kemerelab/EweGo/Hardware/hub_cam/dimensions_stage5.png

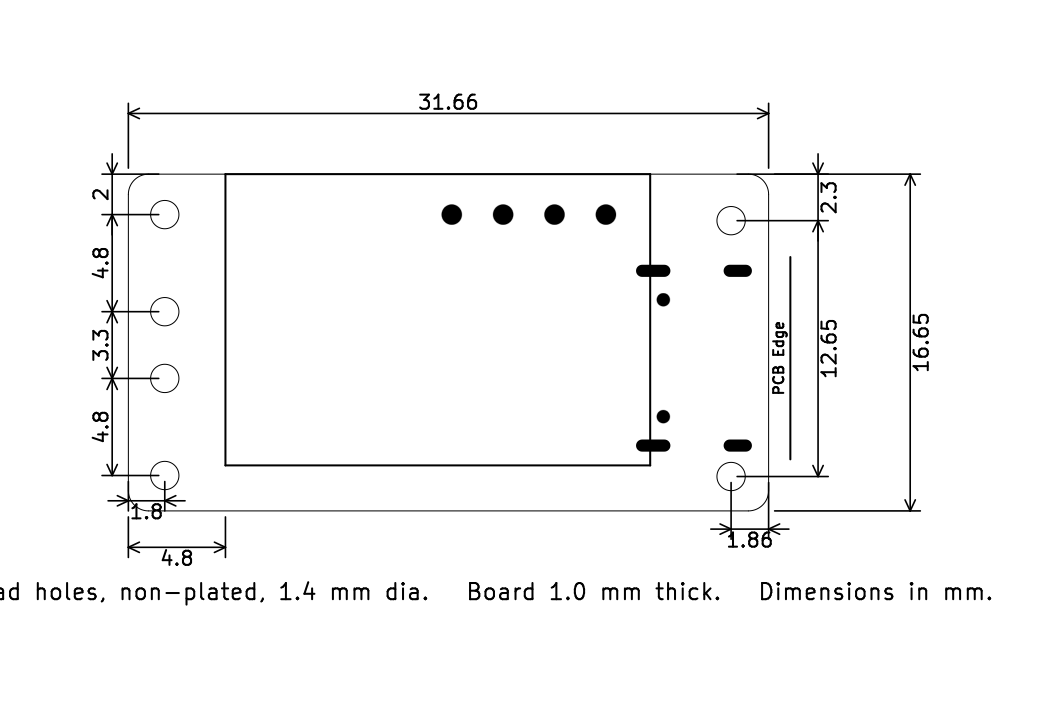
Hardware/hub_cam/dimensions_stage5.png
