kemerelab/EweGo/Hardware/hub_cam/render_stage6_iso.png

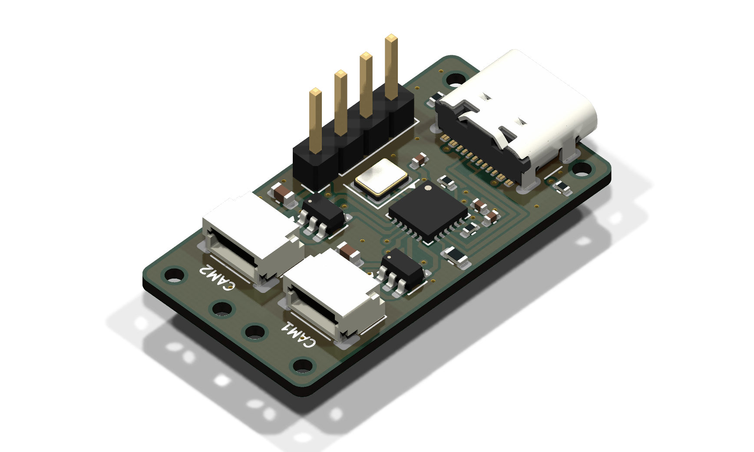
Hardware/hub_cam/render_stage6_iso.png
