kemerelab/EweGo/Hardware/hub_cam/schematic.png

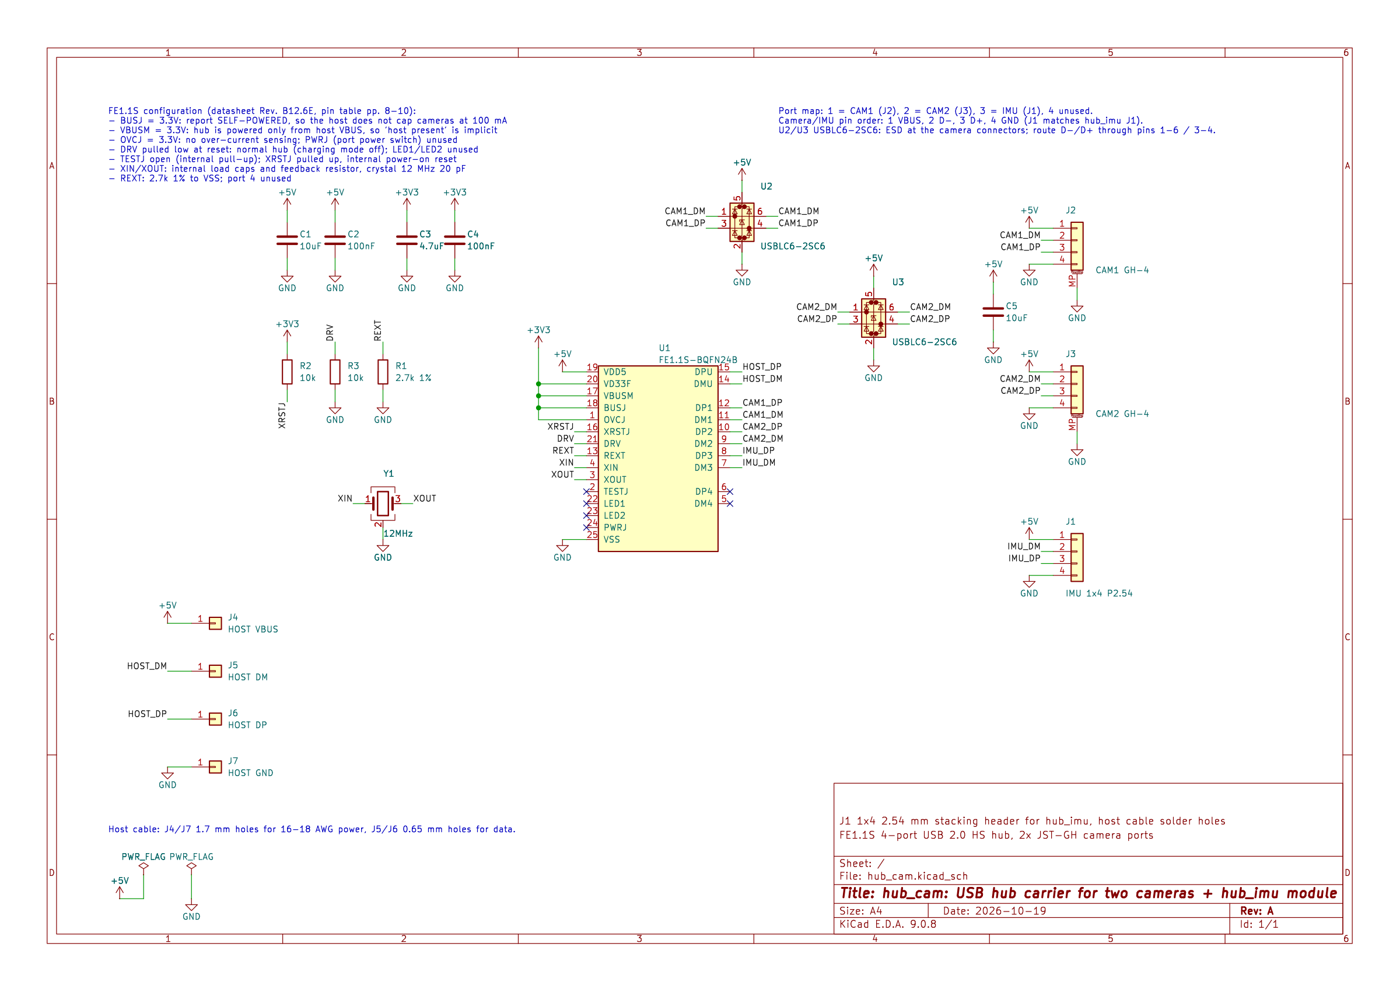
Hardware/hub_cam/schematic.png
