kemerelab/EweGo/Hardware/hub_cam/hub_cam.kicad_pcb

## KiCad design Hardware/hub_cam/hub_cam.kicad_pcb (2026-10-30)

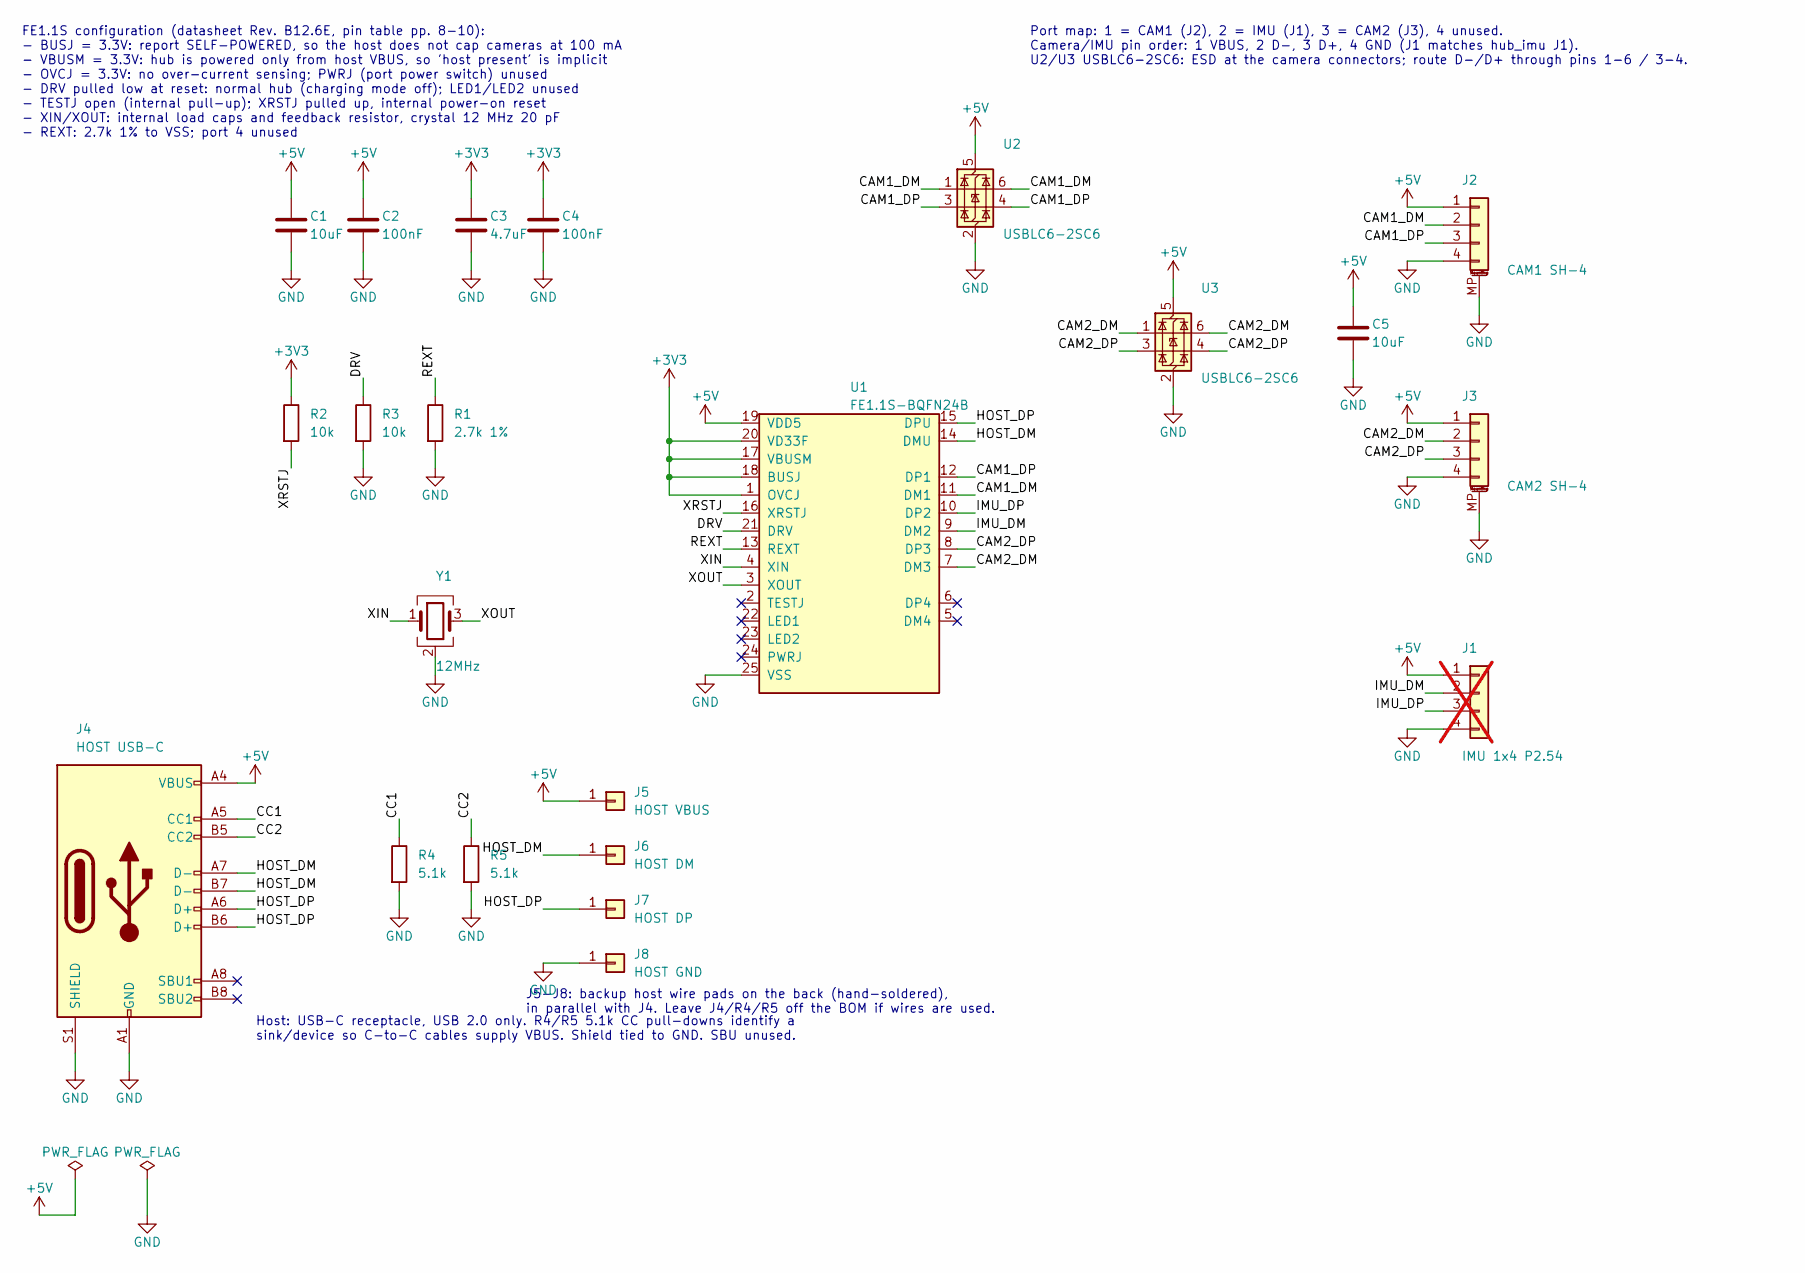
[picture p11: schematic hub_cam.kicad_sch, hub_cam: USB hub carrier for two cameras + hub_imu module]

Parts:
C1, C5: 10uF; C_0603_1608Metric; JLCPCB Part # C96446
C2, C4: 100nF; C_0402_1005Metric; JLCPCB Part # C1525
C3: 4.7uF; C_0402_1005Metric; JLCPCB Part # C23733
J1: IMU 1x4 P2.54; PinHeader_1x04_P2.54mm_Vertical; not fitted
J2: CAM1 SH-4; JST_SH_SM04B-SRSS-TB_1x04-1MP_P1.00mm_Horizontal; JLCPCB Part # C160404
J3: CAM2 SH-4; JST_SH_SM04B-SRSS-TB_1x04-1MP_P1.00mm_Horizontal; JLCPCB Part # C160404
J4: HOST USB-C; USB_C_Receptacle_GCT_USB4105-xx-A_16P_TopMnt_Horizontal; JLCPCB Part # C2765186
J5: HOST VBUS; SolderWirePad_1x01_SMD_1.5x3mm
J6: HOST DM; SolderWirePad_1x01_SMD_1.5x3mm
J7: HOST DP; SolderWirePad_1x01_SMD_1.5x3mm
J8: HOST GND; SolderWirePad_1x01_SMD_1.5x3mm
R1: 2.7k 1%; R_0603_1608Metric; JLCPCB Part # C13167
R2, R3: 10k; R_0402_1005Metric; JLCPCB Part # C25744
R4, R5: 5.1k; R_0402_1005Metric; JLCPCB Part # C25905
U1: FE1.1S-BQFN24B; QFN-24-1EP_4x4mm_P0.5mm_EP2.6x2.6mm; JLCPCB Part # C6776948
U2, U3: USBLC6-2SC6; SOT-23-6; JLCPCB Part # C7519
Y1: 12MHz; Crystal_SMD_3225-4Pin_3.2x2.5mm; JLCPCB Part # C9002

Connections:
+3V3: C3.1, C4.1, R2.1, U1.1 (OVCJ), U1.17 (VBUSM), U1.18 (BUSJ), U1.20 (VD33F)
+5V: C1.1, C2.1, C5.1, J1.1, J2.1, J3.1, J4.A4 (VBUS), J4.A9 (VBUS), J4.B4 (VBUS), J4.B9 (VBUS), J5.1, U1.19 (VDD5), U2.5 (VBUS), U3.5 (VBUS)
/CAM1_DM: J2.2, U1.11 (DM1), U2.1 (I/O1), U2.6 (I/O1)
/CAM1_DP: J2.3, U1.12 (DP1), U2.3 (I/O2), U2.4 (I/O2)
/CAM2_DM: J3.2, U1.7 (DM3), U3.1 (I/O1), U3.6 (I/O1)
/CAM2_DP: J3.3, U1.8 (DP3), U3.3 (I/O2), U3.4 (I/O2)
/CC1: J4.A5 (CC1), R4.1
/CC2: J4.B5 (CC2), R5.1
/DRV: R3.1, U1.21 (DRV)
/HOST_DM: J4.A7 (D-), J4.B7 (D-), J6.1, U1.14 (DMU)
/HOST_DP: J4.A6 (D+), J4.B6 (D+), J7.1, U1.15 (DPU)
/IMU_DM: J1.2, U1.9 (DM2)
/IMU_DP: J1.3, U1.10 (DP2)
/REXT: R1.1, U1.13 (REXT)
/XIN: U1.4 (XIN), Y1.1
/XOUT: U1.3 (XOUT), Y1.3
/XRSTJ: R2.2, U1.16 (XRSTJ)
GND: C1.2, C2.2, C3.2, C4.2, C5.2, J1.4, J2.4, J2.MP (MountPin), J3.4, J3.MP (MountPin), J4.A1 (GND), J4.A12 (GND), J4.B1 (GND), J4.B12 (GND), J4.S1 (SHIELD), J8.1, R1.2, R3.2, R4.2, R5.2, U1.25 (VSS), U2.2 (GND), U3.2 (GND), Y1.2 (G), Y1.4 (G)

Notes on the sheet:
FE1.1S configuration (datasheet Rev. B12.6E, pin table pp. 8-10): - BUSJ = 3.3V: report SELF-POWERED, so the host does not cap cameras at 100 mA - VBUSM = 3.3V: hub is powered only from host VBUS, so 'host present' is implicit - OVCJ = 3.3V: no over-current sensing; PWRJ (port power switch) unused 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
Port map: 1 = CAM1 (J2), 2 = IMU (J1), 3 = CAM2 (J3), 4 unused. Camera/IMU pin order: 1 VBUS, 2 D-, 3 D+, 4 GND (J1 matches hub_imu J1). U2/U3 USBLC6-2SC6: ESD at the camera connectors; route D-/D+ through pins 1-6 / 3-4.
J5-J8: backup host wire pads on the back (hand-soldered), in parallel with J4. Leave J4/R4/R5 off the BOM if wires are used.
Host: USB-C receptacle, USB 2.0 only. R4/R5 5.1k CC pull-downs identify a sink/device so C-to-C cables supply VBUS. Shield tied to GND. SBU unused.

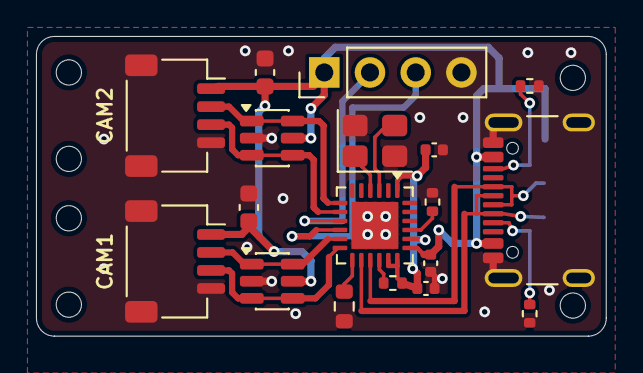
[picture p12: board hub_cam.kicad_pcb from above]

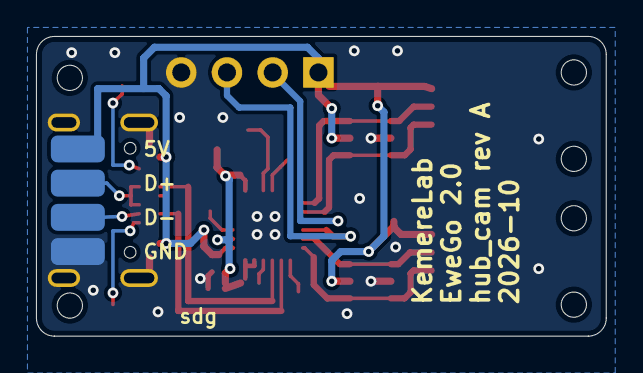
[picture p13: board hub_cam.kicad_pcb from below]

Board: 2 copper layers, 31.7 x 16.7 mm, 22 parts (4 on the bottom side), 18 nets.
