kemerelab/EweGo/Hardware/hub_imu/hub_imu.kicad_pcb

## KiCad design Hardware/hub_imu/hub_imu.kicad_pcb (2026-10-30)

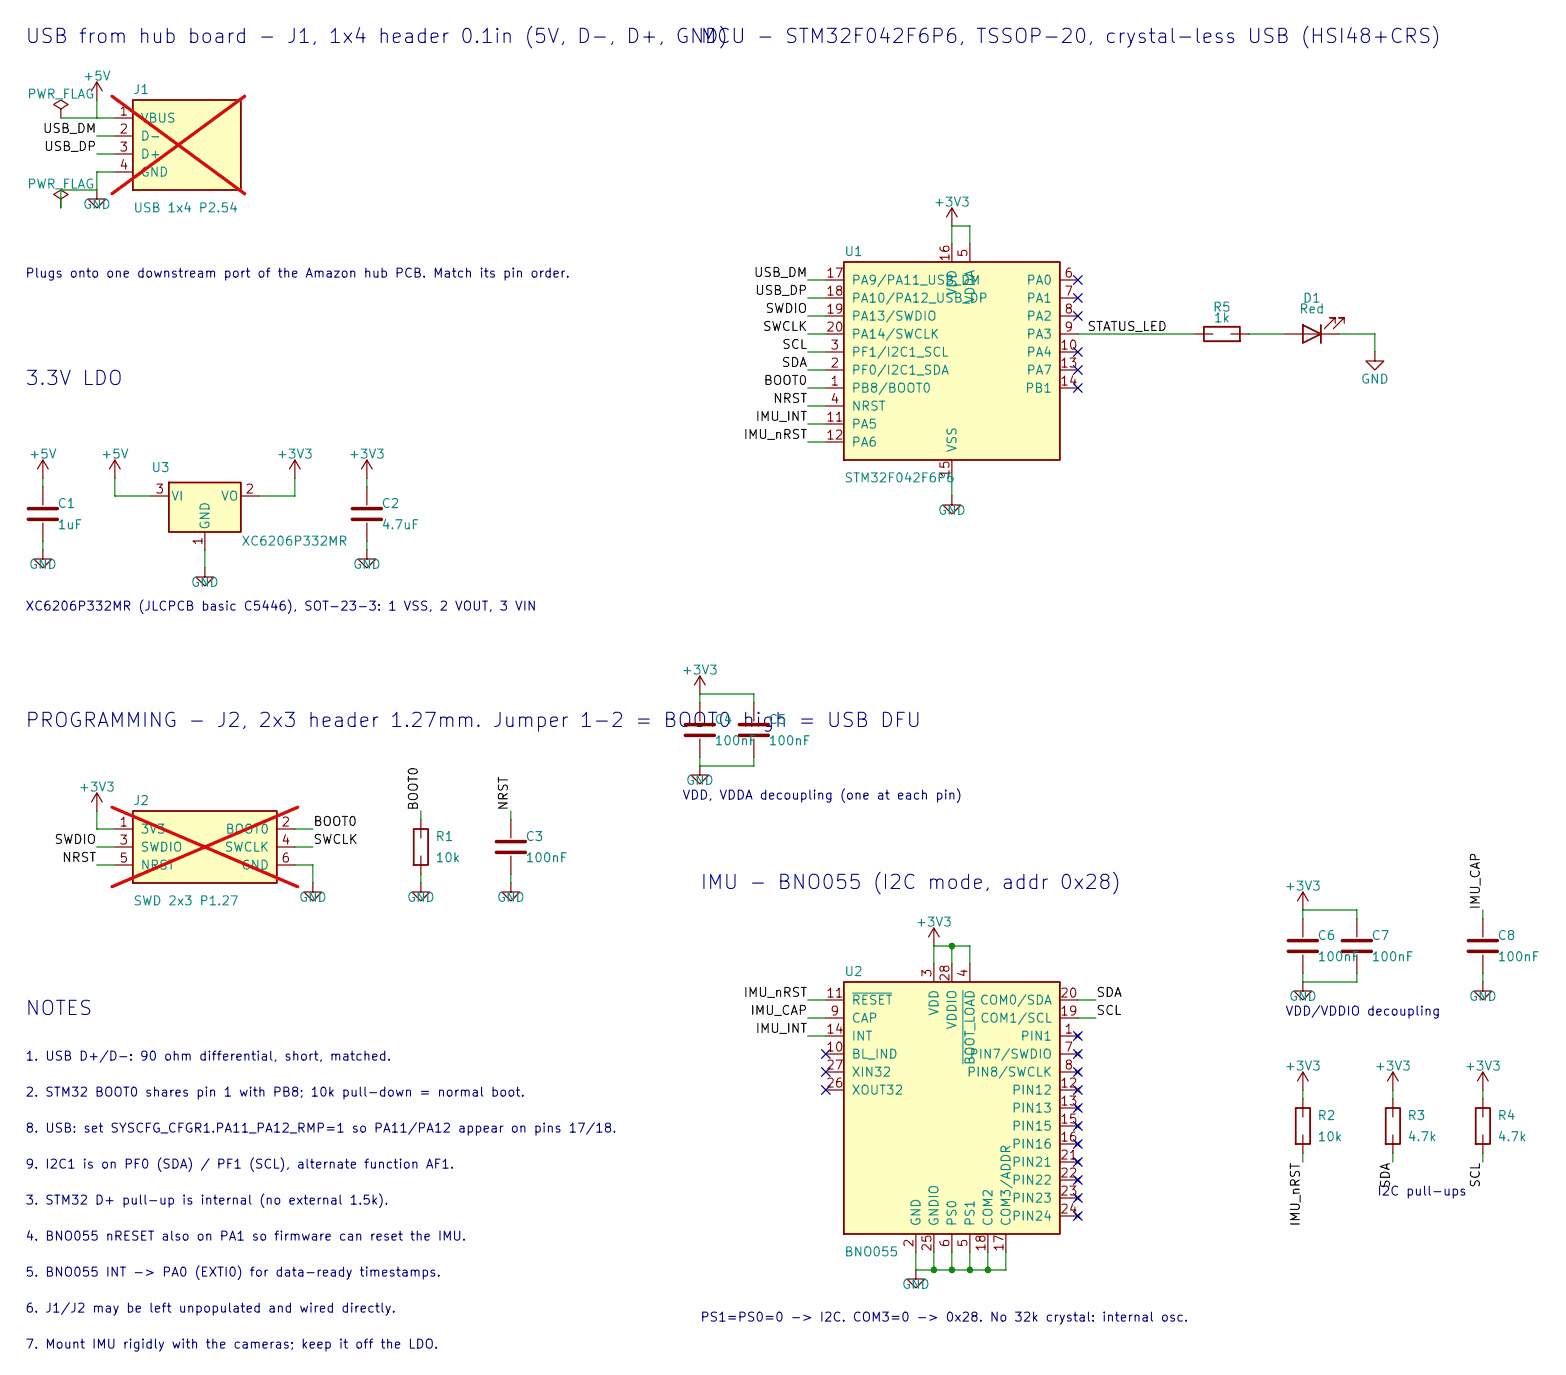
[picture p14: schematic hub_imu.kicad_sch, IMU USB bridge - stacks on hub PCB]

Parts:
C1: 1uF; C_0402_1005Metric; JLCPCB Part # C52923
C2: 4.7uF; C_0402_1005Metric; JLCPCB Part # C23733
C3, C4, C5, C6, C7, C8: 100nF; C_0402_1005Metric; JLCPCB Part # C1525
D1: Red; LED_0603_1608Metric; JLCPCB Part # C2286
J1: USB 1x4 P2.54; PinHeader_1x04_P2.54mm_Vertical; not fitted
J2: SWD 2x3 P1.27; PinHeader_2x03_P1.27mm_Vertical; not fitted
R1, R2: 10k; R_0402_1005Metric; JLCPCB Part # C25744
R3, R4: 4.7k; R_0402_1005Metric; JLCPCB Part # C25900
R5: 1k; R_0402_1005Metric; JLCPCB Part # C11702
U1: STM32F042F6P6; TSSOP-20_4.4x6.5mm_P0.65mm
U2: BNO055; LGA-28_5.2x3.8mm_P0.5mm
U3: XC6206P332MR; SOT-23-3; JLCPCB Part # C5446

Connections:
+3V3: C2.1, C4.1, C5.1, C6.1, C7.1, J2.1 (3V3), R2.1, R3.1, R4.1, U1.5 (VDDA), U1.16 (VDD), U2.3 (VDD), U2.4 (~BOOT_LOAD), U2.28 (VDDIO), U3.2 (VO)
+5V: C1.1, J1.1 (VBUS), U3.3 (VI)
/BOOT0: J2.2 (BOOT0), R1.1, U1.1 (PB8/BOOT0)
/IMU_CAP: C8.1, U2.9 (CAP)
/IMU_INT: U1.11 (PA5), U2.14 (INT)
/IMU_nRST: R2.2, U1.12 (PA6), U2.11 (~RESET)
/NRST: C3.1, J2.5 (NRST), U1.4 (NRST)
/SCL: R4.2, U1.3 (PF1/I2C1_SCL), U2.19 (COM1/SCL)
/SDA: R3.2, U1.2 (PF0/I2C1_SDA), U2.20 (COM0/SDA)
/STATUS_LED: R5.1, U1.9 (PA3)
/SWCLK: J2.4 (SWCLK), U1.20 (PA14/SWCLK)
/SWDIO: J2.3 (SWDIO), U1.19 (PA13/SWDIO)
/USB_DM: J1.2 (D-), U1.17 (PA9/PA11_USB_DM)
/USB_DP: J1.3 (D+), U1.18 (PA10/PA12_USB_DP)
GND: C1.2, C2.2, C3.2, C4.2, C5.2, C6.2, C7.2, C8.2, D1.1 (K), J1.4 (GND), J2.6 (GND), R1.2, U1.15 (VSS), U2.2 (GND), U2.5 (PS1), U2.6 (PS0), U2.17 (COM3/ADDR), U2.18 (COM2), U2.25 (GNDIO), U3.1 (GND)
unnamed: D1.2 (A), R5.2

Notes on the sheet:
3. STM32 D+ pull-up is internal (no external 1.5k).
Plugs onto one downstream port of the Amazon hub PCB. Match its pin order.
IMU - BNO055 (I2C mode, addr 0x28)
8. USB: set SYSCFG_CFGR1.PA11_PA12_RMP=1 so PA11/PA12 appear on pins 17/18.
PROGRAMMING - J2, 2x3 header 1.27mm. Jumper 1-2 = BOOT0 high = USB DFU
7. Mount IMU rigidly with the cameras; keep it off the LDO.
9. I2C1 is on PF0 (SDA) / PF1 (SCL), alternate function AF1.
I2C pull-ups
USB from hub board - J1, 1x4 header 0.1in (5V, D-, D+, GND)
VDD, VDDA decoupling (one at each pin)
PS1=PS0=0 -> I2C. COM3=0 -> 0x28. No 32k crystal: internal osc.
5. BNO055 INT -> PA0 (EXTI0) for data-ready timestamps.
1. USB D+/D-: 90 ohm differential, short, matched.
6. J1/J2 may be left unpopulated and wired directly.
NOTES
VDD/VDDIO decoupling
MCU - STM32F042F6P6, TSSOP-20, crystal-less USB (HSI48+CRS)
3.3V LDO
XC6206P332MR (JLCPCB basic C5446), SOT-23-3: 1 VSS, 2 VOUT, 3 VIN
4. BNO055 nRESET also on PA1 so firmware can reset the IMU.
2. STM32 BOOT0 shares pin 1 with PB8; 10k pull-down = normal boot.

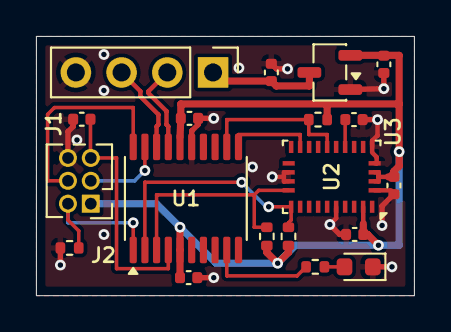
[picture p15: board hub_imu.kicad_pcb from above]

Board: 2 copper layers, 21.0 x 14.4 mm, 19 parts (0 on the bottom side), 16 nets.
