kemerelab/EweGo/(commit log)

2026-01-03 Updated dual camera script with excess removed
2026-07-15 record_sensors: replace sensor_test.py with expanded orchestrator
    The unified sensor orchestrator moves from Firmware/sensor_test.py to
    Firmware/record_sensors.py (new file, ~780 lines vs. 460). Docs and
    downstream references updated to match the new path.
    [record_sensors.py]
2026-07-15 setup: RTC substitute, boot pre-sync, persistent journal, sensor service
    pi_setup.sh gains four sections that harden unattended operation:
    §7.5 Wall-clock save/restore. CM4 has no battery RTC; a minute-cadence
    touch on /var/lib/ewego/clock plus a boot-time forward-only step
    bounds post-reboot staleness to ~60 s. Prevents the 2026-07-08
    time-island split where a stale-anchor ewe1 was outvoted by the
    rest of the flock as a falseticker.
    §7.6 Boot pre-sync via `chronyd -q` against any live mesh peer before
    chronyd starts. If a peer answers within 25 s the node rejoins
    at ~0 offset; on cold-boot with no peers it falls back to the
    r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
2026-07-15 mesh: ops tooling (list/record/monitor) + BSSID and OGM tuning
    New helpers for the mesh once it's up:
    mesh_list.sh - ping-sweep bat0, print IP/MAC/hostname table,
    cross-checked against batman-adv originator count.
    mesh_record.sh - start/stop/status for record_sensors.py --no-gps on
    every peer over SSH. Standalone fallback for when
    mesh_monitor is unavailable.
    mesh_monitor.py - TUI on the laptop showing per-peer chrony tracking,
    pairwise offset spread, fuel gauge, storage, recording
    status, and the batman-adv TQ matrix. [r]/[s] drive
    the sensor service; [b] bursts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
2026-07-15 chrony/GPS: SHM refclock + xleave polling + trusted laptop source
    New gps-test/chrony_shm.py wraps SysV IPC segment 'NTP0'+N so chrony's
    `refclock SHM N` picks up GPS time samples. Segment layout matches
    gpsd/ntpsec conventions; unit 0 by default. Silent no-op on OSError.
    gps_logger.py feeds each valid NAV-PVT fix into segment 0 (paired with
    `refclock PPS ... lock GPS` in chrony.conf for sub-µs alignment). Falls
    back to mesh peers if SHM setup fails.
    chrony.conf tuning:
    - Mesh peers now `minpoll 0 maxpoll 2 xleave polltarget 30 maxdelay 0.1`.
    xleave gives ~100µs better than software RX timestamping. polltarget
    30 (vs default 8) keeps chrony actually polling at 1-4 s. maxdelay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
    [chrony_shm.py, gps_logger.py]
2026-07-15 sync_validation: multi-pair summary + NaN-safe drift fit
    analyze_sync.py:
    - New summary_plot() combining residual lag(t) for all pairs plus
    ppm/scatter bar charts, giving a single overview figure for a
    ref-vs-N validation run.
    - Guard the audio-drift np.polyfit against <2 in-band samples. A pair
    with lag spread across many ms yields keep.sum()<2 after the ±0.5 ms
    median filter; return NaN ppm/scatter and log a warning instead of
    crashing.
    - Return the raw ats/alag arrays from overview_figure so summary_plot
    can re-plot them without recomputing GCC-PHAT.
    - Doc: recorder name updated to record_sensors.py.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
2026-07-15 dualcam: rebase-safe timestamps, aligned export, UDP mesh preview
    bugs/002 documents picamera2's per-encoder timestamp rebase to zero
    (Michigan Apr 2026 captures show first frame = 0, µs-since-first-frame
    after — not directly cross-alignable).
    dual_cam_jp2.py fix:
    - New on-disk format tagged with "EWEGOTS2" magic, storing (pi_us,
    rebased_us) pairs. pi_us is time.monotonic_ns()//1000 at outputframe
    time; rebased_us is picamera2's SoF-accurate delta. Reconstruct
    absolute monotonic timestamps as pi_us[0] + rebased_us[i].
    - Per-camera stall watchdog: last_frame_pi_us tracked so a silent
    single-camera death (ewe5 2026-07-09: cam2 stopped ~25 s in) can
    trip a monitor ra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
    [align_streams.py, dual_cam_jp2.py, play_with_timestamps.py]
2026-07-15 sensors: cadence-batched fsync on companion CSVs
    Michigan 2026-04-13: a hardware watchdog reset produced kilobytes of
    trailing NUL bytes on IMU/audio/fuel-gauge companion CSVs. Filehandle
    flush() only pushes to the kernel — the SD card firmware buffered the
    writes and lost them on reset.
    - IMU: fsync every ~1 s (batched with the existing 10-sample flush).
    - Audio: fsync the timestamps CSV every ~1 s from the main thread
    (never inside the sounddevice RT callback). The WAV survives via
    RIFF finalize on context-manager exit.
    - Fuel gauge: per-row fsync — writer runs at 0.5 Hz so 2 syncs/min is
    negligible SD wear and caps loss at one sample.
    Caps data loss at <1 s across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
    [log_imu_data.py, max17048_test.py]
2026-07-15 setup: tty_probe.py — diagnose cbreak single-key input
    Small standalone diagnostic for when mesh_monitor's [r]/[s]/[b] keys
    don't register — reports isatty state, TERM, foreground pgid, and
    echoes raw bytes on each keypress. Helps distinguish line-buffering,
    multiplexer interception, and non-TTY stdin.
2026-07-15 dualcam/README: document align_streams.py multi-device export
    Adds a section covering align_streams.py: what it composites, how
    clock-sync rectification and wall-clock alignment work, an annotated
    five-device example command (fiveway_0459_final_1620p30.mp4), the
    common CLI flags including --wall-offset, and the multi-device row
    layout.
2026-09-04 Add CI-built collar image (Phase A)
    Builds a ready-to-flash Raspberry Pi OS Lite arm64 image with the current
    Python firmware installed but not enabled, apt packages (picamera2, smbus2,
    pyserial, i2c-tools) installed inside the image at build time via an
    emulated chroot, pyubx2 vendored as pure wheels, USB host mode verified,
    UART0 console kept, and the pi_setup.sh hardware block in config.txt.
    Wi-Fi/hostname/user come from Raspberry Pi Imager; no first-boot steps.
2026-09-04 Add ffmpeg to the collar image
    For ad-hoc USB camera streaming and transcoding tests; not used by the
    recording scripts.
2026-09-05 Add browser test console (ewego-webtest) to the collar image
    Single-file, stdlib-only HTTP server on port 8080: status strip (image
    version, clock sync, battery, disk, devices, unit states), one test per
    sensor with streamed output, live MJPEG camera view via v4l2-ctl, unit
    start/stop and journal tails, session listing. Enabled by default on the
    image; no authentication, bench/lab networks only.
2026-09-09 GPS: 5 Hz navigation rate, PPS on GPIO 6, documented module configuration
    - SheepRTK.ucf: CFG-RATE-MEAS 100 -> 200 ms so RXM-RAWX on all bands
    stays well inside 460800 baud
    - validate_ubx.py and the GPS docs now expect ~5 Hz
    - CONFIGURING_HW.md decodes every key the .ucf files set, records the
    UART/timepulse pin mapping from the eweSAW schematic (data on UART4,
    TP1 on GPIO 6), and describes software and PPS timing
    - image: dtoverlay=pps-gpio,gpiopin=6 so /dev/pps0 exists
2026-09-09 image: leave GPIO 4/5 (unused UART3 to the GNSS header) as unpulled inputs
    The module's second UART is not used; with the uart3 overlay loaded GPIO 4
    was an actively driven TX output on the header, and even without it the
    default pull-up shows 3.3 V there. gpio=4,5=ip,pn makes both pins plain
    floating inputs from firmware onward.
2026-09-09 webtest: PPS feedback
    Status strip shows /dev/pps0 presence, live/stale, sequence, measured
    rate, and the system clock's offset from the GPS second at the last edge.
    GPS card gains a 'PPS watch' that prints every edge for N seconds with
    inter-edge interval and offset, and flags missed edges.
    [ewego_webtest.py]
2026-09-09 webtest: simultaneous multi-camera drop test
    Runs v4l2-ctl --verbose on every camera at once to /dev/null and accounts
    for lost frames from the kernel per-buffer sequence numbers: per camera
    frames received, gaps and where, error-flagged frames, effective fps,
    interval min/max, data rate; PASS/FAIL plus recent UVC/USB dmesg lines.
    [ewego_webtest.py]
2026-09-09 webtest: make the multi-camera drop test explain a silent camera
    - v4l2-ctl --stream-poll so a camera that starts but never delivers a
    frame reports 'select timeout' instead of blocking until killed
    - staggered starts (default 1 s) to avoid simultaneous alt-setting
    negotiation on the shared USB 2.0 root
    - progress marks cameras streaming with no frames; result block says
    whether v4l2-ctl exited or was killed, quotes its output, and gives the
    usual causes; kernel messages during the test and lsusb -t appended
    - buttons to reload uvcvideo with/without quirks=128 (bandwidth fix)
    [ewego_webtest.py]
2026-09-09 webtest: list only USB cameras, selectable for the drop test
    Enumerate cameras from /dev/v4l/by-path/*usb*-video-index0 (one capture
    node per UVC camera, labelled by physical hub port) instead of every
    V4L2 node, which on a Pi includes the codec, ISP and HEVC devices. The
    drop test gets a checkbox per camera.
2026-09-09 webtest: UVC bandwidth probe and live alt-setting in the drop test
    Shows what each camera asks the bus for (alternate setting and bytes per
    microframe) via uvcvideo tracing, and the drop test reports the live alt
    setting per camera. On the Pi 6.12 kernel quirks=128 only affects
    uncompressed formats, so an MJPEG camera's own request is what counts.
2026-09-09 Patched uvcvideo with a max_payload cap, built into the image
    Two of the collar's MJPEG cameras cannot share the CM4's single USB 2.0
    bus: the camera requests 3060 B/microframe at every format and the bus
    budget is ~6000. quirks=128 only rewrites uncompressed requests on the
    6.12 kernel. This adds a 'max_payload' module parameter (patch anchored on
    exact source lines, verified in CI against rpi-6.12.y), builds the module
    in the image chroot against the exact kernel headers, installs it under
    /lib/modules/<ver>/updates/, and sets max_payload=2048 via modprobe.d.
    Also: CLAUDE.md handoff notes for cloud sessions; web console shows the
    module path and max_payload in the bandwidth probe.
    Co-Aut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
2026-09-09 Add ewego-cam: static C UVC recorder with kernel timestamps and drop accounting
    Single-file V4L2 recorder (no libuvc): writes concatenated MJPEG frames,
    int64 us CLOCK_MONOTONIC timestamps (same format as the CSI recorder),
    a 32-byte index record per frame (offset, timestamp, driver sequence,
    bytes, flags) and a JSON summary with lost/gap/error counts, interval
    statistics and the realtime-minus-monotonic offset. Exit 2 on any lost or
    error-flagged frame, 3 on stall. Device selection by USB hub port
    (port:1.3) via /dev/v4l/by-path. sd_notify status line without libsystemd.
    CI compiles it natively with -Werror and cross-compiles a static arm64
    binary that the image injector installs to /usr/l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
    [ewego_webtest.py]
2026-09-09 Zero free space before compressing the image; strip ewego-cam; recorder test in the console
    The purged build tools left dirty free blocks that xz could not compress
    (~130 MB of extra download). zerofree on the unmounted rootfs before
    hashing brings the image back to size. ewego-cam is linked with -s.
    The web console gains 'Record test with ewego-cam' for the selected
    cameras, showing each recorder's live stats and summary.json.
2026-09-09 uvcvideo: hold kernel packages; console probe shows kernel/module inventory
    A collar running a different kernel than the image was built with loads
    the stock uvcvideo (no max_payload). The probe now prints uname -r, the
    module path in use, each /lib/modules/* with its updates/ contents, the
    modprobe setting and the image version, and the image holds the kernel
    packages so apt upgrade cannot cause the mismatch.
2026-09-09 image: no apt at first boot (cloud-init package module removed), avahi-daemon baked in
    Raspberry Pi Imager's cloud-init user-data installs avahi-daemon and can
    run a full package upgrade on first boot. On the test collar that replaced
    the kernel (6.18.34 -> 6.18.39), so the patched uvcvideo built for the
    image's kernel was no longer the one loading. The injector now writes
    /etc/cloud/cloud.cfg.d/99-ewego-no-apt.cfg that drops the package module
    from cloud_config_modules (user-data cannot re-add a module), and
    avahi-daemon is installed at build time instead. Kernel packages are also
    held (previous commit). Console gets an 'apt / first-boot history' button.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
    [ewego_webtest.py]
2026-09-09 image: strip the cloud-init package module from whichever stage list holds it
2026-09-09 webtest: alternate-setting table, live max_payload setter, reserved bandwidth from the kernel trace
    The cap selects the smallest alternate setting at or above it; this camera
    has none between 2048 and 2880, so max_payload=2048 lands on 2880 and two
    cameras still exceed the bus budget. The probe now lists the camera's
    alternate settings (from lsusb, which shows the high-bandwidth multiplier
    sysfs hides), the console can set max_payload at runtime, and the drop
    test reports each camera's actual reservation and the total.
2026-09-09 uvcvideo: max_payload default 1900 (bench PASS: two cameras 1080p30, 0 lost)
    The collar camera's alternate settings are 800/944/1280/1600/1984/2880/
    3060 B/microframe and the driver rounds the capped request up, so 2048
    landed on 2880 and two cameras still exceeded the bus; 1900 lands on 1984,
    3968 total, zero frames lost on both cameras at 1920x1080 30 fps. Console
    alt-setting table now excludes the cameras' audio interfaces.
2026-09-10 ewego-cam 0.2: writer thread with steady writeback; uvcvideo keeps 32 URBs in flight
    Bench: two cameras recording 1080p30 to the SD card lost 5-9 frames each
    at every 5 s fdatasync (200-340 ms stalls) although v4l2-ctl to /dev/null
    at the same settings lost none. The capture thread now only dequeues,
    copies into a RAM queue (--ring, 64 MB) and requeues; a writer thread
    drains it, starting writeback every --wb MB (4) with sync_file_range and
    dropping written chunks from the page cache, so there is no periodic
    flush burst. Queue overruns, queue peak and the longest write are reported.
    The driver patch also raises UVC_URBS 5 -> 32 (~20 ms -> ~128 ms of
    USB-side buffering) since URB resubmission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
2026-09-10 notes: v0.4.5 built (writer thread, 32 URBs)
2026-09-10 gps_logger: NTRIP configurable and bounded, off by default
    The caster was hard-coded to the lab LAN and connect() had no timeout,
    so away from the lab the logger blocked for up to two minutes at start
    (and a systemctl stop during that window showed a KeyboardInterrupt
    traceback). Now: --ntrip HOST:PORT/MOUNTPOINT[,USER:PASS] or $EWEGO_NTRIP,
    --no-ntrip, 5 s connect timeout, 10 s recv timeout; the unit reads
    NTRIP_ARGS from /etc/ewego/gps.conf (empty = no corrections).
    [gps_logger.py]
2026-09-10 webtest: serial-over-TCP bridge for PyGPSClient
    Exposes the GNSS UART on a TCP port (default 5010), both directions, one
    client at a time, from the GPS card. Refuses while ewego-gps owns the
    port; shares the raw-read lock. Standard library only.
2026-10-03 image: add dfu-util for flashing the hub_imu USB IMU module through the hub
2026-10-04 hub_imu firmware step 1: USB enumeration, LED, console with dfu reboot
    Bare CMSIS + TinyUSB 0.21 for the STM32F042F6P6 on the hub_imu module
    (Firmware/hub_imu/). Composite CDC console + HID data interface (HID is
    present but idle until step 3). HSI48 + CRS, PA11/PA12 remap, SysTick
    LED blink, 'dfu' command reboots into the system bootloader via a
    .noinit magic word checked in Reset_Handler.
    Own workflow (hub-imu-firmware.yml): fetch pinned deps, build with
    gcc-arm-none-eabi, enforce flash/RAM budget, upload hub_imu.bin; release
    on hubimu-v* tags. The image workflow now ignores Firmware/hub_imu/.
    [main.c, startup.c, tusb_config.h]
2026-10-04 hub_imu firmware step 2: I2C and BNO055 bring-up on the console
    I2C1 master on PF0/PF1 (100 kHz from SYSCLK, timeouts, NACK handling);
    BNO055 reset via PA6, chip-ID poll, NDOF mode. Console gains id (chip,
    sensor and firmware IDs, sys_status/sys_err), cal, read (formatted
    46-byte burst with its I2C time), init. LED blinks 2 Hz if the sensor
    failed. USB is serviced during the sensor's boot delay. CI adds a DFU
    suffix (hub_imu.dfu) alongside the raw .bin.
    [bno055.c, bno055.h, i2c.c, i2c.h, main.c]
2026-10-05 hub_imu firmware step 3: 100 Hz HID sample stream
    One 64-byte HID report per sample (report.h): version, flags, 16-bit
    sequence, 32-bit device microsecond timestamp from a free-running TIM2,
    the 46-byte BNO055 burst, the I2C read time and the period. Sampling is
    paced by the device clock with resync if it falls behind; reports the
    host did not drain are counted and flagged. I2C moved to 400 kHz.
    Console: stats, stream (toggle).
2026-10-05 ewego-imu-usb host logger, unit, console card; CI builds it
    Static C logger for the hub_imu HID stream: finds the module by VID:PID,
    stamps each report with CLOCK_MONOTONIC/REALTIME, writes the UART-era IMU
    CSV columns plus host_mono_us/dev_ts_us/seq/i2c_us/flags, counts sequence
    gaps and flagged samples, reports device-vs-host drift; summary.json; exit
    2 on loss. Unit ewego-imu-usb reads /etc/ewego/imu-usb.conf. Console gets
    a USB IMU card (read stream, start/stop/journal). Firmware stats buffer
    widened.
    [ewego-imu-usb.c, ewego_webtest.py, main.c]
2026-10-05 bus-test.py: IMU + camera bus test for macOS (IOKit via ctypes, ffmpeg) and Linux (hidraw, v4l2-ctl)
    Verified on the Mac: hub_imu at 100.0 Hz, 0 lost, device-clock intervals
    9992-10008 us, while one or two cameras stream. On macOS ffmpeg's
    avfoundation only reaches the cameras' raw 5 fps mode, so cameras there
    are a bus load, not a frame-rate test; the collar does the counting.
2026-10-06 Camera listing: one entry per device node (udev makes -usb- and -usbv2- by-path links)
2026-10-06 notes: collar bus test passed (two cameras 1080p30 + IMU 100 Hz, 0 lost)
2026-10-07 units: word-split EXTRA_ARGS/DEVICE_ARG ($VAR, not ${VAR}) so ewego-cam and ewego-imu-usb get separate arguments
    With braces systemd passes the whole value as one argument, so
    ewego-cam received an option literally named '--stats 5' and exited 1.
2026-10-07 ewego-cam 0.3: hold the frame rate (clear UVC exposure-auto-priority) unless --auto-fps
    Both cameras delivered 24.4 fps in a dim room with contiguous sequence
    numbers: auto-exposure was lengthening the exposure past the frame
    period. Logging wants a constant rate and darker frames.
2026-10-07 recorders wait for their device after a hub reset instead of failing
    A hub reset re-enumerates the cameras and the IMU module a few seconds
    later than systemd's restart; ewego-cam (--wait, 30 s) and ewego-imu-usb
    now poll for the device before giving up.
    [ewego-imu-usb.c]
2026-10-30 Move hub_imu and hub_cam boards into Hardware/, firmware with its board
    - Hardware/hub_imu (EweFeel USB IMU) and Hardware/hub_cam (camera hub)
    copied from github.com/ckemere/usb-imu at 4be5fb1, without history;
    that repo keeps it. Each board gets a NOTES.md (history, status,
    gotchas) next to its README; Hardware/README.md indexes the folder.
    - Firmware/hub_imu -> Hardware/hub_imu/firmware; hub-imu-firmware.yml
    follows, and the image build now ignores Hardware/**.
    - README: project name expansion (Extensible Wearable for Egocentric and
    Group Observation) and a shorter overview.
    - .gitignore: firmware build dirs at the new path, KiCad transient files,
    .DS_Store.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
2026-10-30 docs: call the device a wearable (collar and head-halter variants)
    "Collar" stays where it means the collar variant or the test unit.
2026-11-13 Make the USB recorders the default: ewego-record.target, no Picamera2
    ewego-sensors launched the Picamera2 dual-camera script; with no CSI
    cameras libcamera hands it the USB webcams through its UVC pipeline and
    configure() fails ("Control FrameDurationLimits is not advertised").
    - image/units/ewego-record.target wants ewego-cam@camera1/2, ewego-imu-usb,
    ewego-gps and the new ewego-audio (record_audio.py / arecord) and
    ewego-fuel (Firmware/fuel_gauge/log_fuel_gauge.py, same CSV columns as
    sensor_test.py wrote); members are PartOf= the target so stop/restart
    propagate. /etc/ewego/audio.conf and fuel.conf added.
    - ewego-sensors and ewego-dualcam units removed; python3-picamera2, the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
2026-11-13 CI: pin runners to ubuntu-24.04
    ubuntu-latest moved to Ubuntu 26.04 on 2026-11; the image job failed at
    'Install build tools' with "Package 'qemu-user-static' has no installation
    candidate". Pin all jobs to 24.04, where every previous image built.
2026-11-13 Camera confs default to hub_cam ports 1.1 / 1.3
    On the collar ewego-cam --list showed the cameras on port:1.1 and port:1.3
    (the hub_cam layout); v0.6.0 shipped 1.3 / 1.4 from the hand-wired hub, so
    camera2 waited for an empty port and only one camera recorded.
2026-11-13 ewego-cam 0.4: --device auto:N[/M] picks cameras by hub-port order
    The camera confs no longer name a hub port. auto:N/M enumerates the USB
    cameras from /dev/v4l/by-path, orders them by hub port (strverscmp, so
    1.1 < 1.3 < 1.10) and takes the Nth, expecting M in all. camera1 is thus
    the camera on the lower port on any hub, independent of /dev/videoN
    numbering. The set must be unchanged for three 500 ms polls before the
    choice is made (after a hub reset the cameras come back one at a time);
    if fewer than M appear within --wait the recorder uses what is there and
    says so, rather than record nothing. --list prints both auto: and port:
    forms. Confs default to auto:1/2 and auto:2/2; port: still pi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
2026-11-13 v0.6.3: threaded IMU logger, live field dashboard, run check, console shutdown
    ewego-imu-usb 0.3: reader thread (hidraw poll + timestamps only, --rt for
    SCHED_FIFO) and writer thread behind a RAM ring of 8192 samples, after 0.2
    lost 480 samples in 9 gaps when its CSV write blocked on the SD card under
    camera load (the kernel keeps 64 reports per hidraw reader). Ring overruns
    are counted in the summary and fail the exit code.
    Both C recorders take --live DIR (newest JPEG and counters for the cameras,
    counters plus the last 64 samples for the IMU, on tmpfs) and --preview
    (live files only, nothing recorded). The confs enable --live /run/ewego
    and --rt for the IMU.
    Console: /live dashboard (tw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
